embedrapp/parking-ultrasonic/pcb/bom.csv

Quantity | References | Populate | Value | Package | Mount | Manufacturer | MPN | Supplier | Supplier Part Number | Alternatives | Description | Datasheet | Configuration | Zener Paths | Source URL | Currency | Unit Price | Extended Price | Stock | Availability | Sourcing Updated
1 | BZ1 | Yes |  | Radial 12.2 mm, 5 mm pitch |  | TDK | PS1240P02BT |  |  |  | Buzzer, polarized | https://product.tdk.com/en/system/files/dam/doc/product/sw_piezo/sw_piezo/piezo-buzzer/catalog/piezoelectronic_buzzer_ps_en.pdf | Configured | parking_ultrasonic.zen:<root>.BZ1.PS1240P02BT
1 | C1 | Yes | 10uF 16V X5R | 0805 | smt | Samsung Electro-Mechanics | CL21A106KOQNNNE |  |  |  | 10uF 16V X5R |  | Configured | parking_ultrasonic.zen:<root>.C1.C
3 | C2 C4 C5 | Yes | 100nF 50V X7R | 0805 | smt | Samsung Electro-Mechanics | CL21B104KBCNNNC |  |  |  | 100nF 50V X7R |  | Configured | parking_ultrasonic.zen:<root>.C2.C | parking_ultrasonic.zen:<root>.C4.C | parking_ultrasonic.zen:<root>.C5.C
1 | C3 | Yes | 1uF 16V X7R | 0805 | smt | Samsung Electro-Mechanics | CL21B105KOFNNNE |  |  |  | 1uF 16V X7R |  | Configured | parking_ultrasonic.zen:<root>.C3.C
1 | D1 | Yes |  | T-1 3/4 5 mm 3-lead radial |  | SunLED | XLMDKVG59MCA |  |  |  | Dual LED, common anode on pin 2 | https://www.sunledusa.com/products/spec/XLMDKVG59MCA.pdf | Configured | parking_ultrasonic.zen:<root>.D1.XLMDKVG59MCA
1 | D2 | Yes | 5V TVS Diode | DO-214AC |  | Littelfuse | SMAJ5.0A |  |  |  | 5V TVS Diode |  | Configured | parking_ultrasonic.zen:<root>.D2.D
1 | D3 | Yes | LED GREEN | 0805 |  | Lite-On | LTST-C171KGKT |  |  |  | LED GREEN |  | Configured | parking_ultrasonic.zen:<root>.D3.LED
1 | DS1 | Yes |  | 0.96 inch 128x64 OLED breakout module with 1x8 2.54 mm header and STEMMA QT connectors |  | Adafruit Industries | 326 |  |  |  | Adafruit PID 326 0.96 inch 128x64 monochrome SSD1306 OLED breakout with STEMMA QT / Qwiic I2C connectors, 1x8 through-hole header, I2C default configuration, and optional SPI wiring. | https://cdn.embedr.app/components/adafruit-326-ssd1306-oled/datasheet_pdf/UG-2864HSWEG01.pdf | Configured | parking_ultrasonic.zen:<root>.DS1.ADAFRUIT_326_SSD1306_OLED
1 | F1 | Yes |  | 1206 |  | Bourns | MF-NSMF050-2 |  |  |  | Resettable fuse, polymeric positive temperature coefficient | https://www.bourns.com/docs/Product-Datasheets/mf-nsmf.pdf | Configured | parking_ultrasonic.zen:<root>.F1.MF_NSMF050_2
1 | J1 | Yes |  | JST XH 1x10 side entry |  | JST | S10B-XH-A(LF)(SN) |  |  |  | Generic connector, single row, 01x10, script generated (kicad-library-utils/schlib/autogen/connector/) | https://www.jst-mfg.com/product/pdf/eng/eXH.pdf | Configured | parking_ultrasonic.zen:<root>.J1.S10B_XH_A
1 | J2 | Yes |  | HC-SR04 module plugged into Sullins PPPC041LGBN-RC right-angle 1x4 socket |  | SparkFun Electronics | SEN-15569 |  |  |  | SparkFun SEN-15569 5 V HC-SR04 ultrasonic distance sensor module with a 4-pin VCC/TRIG/ECHO/GND interface, 2 cm to 4 m measurement range, and 10 us trigger pulse timing. | https://cdn.embedr.app/components/sparkfun-sen-15569-hc-sr04/datasheet_pdf/HCSR04.pdf | Configured | parking_ultrasonic.zen:<root>.J2.SPARKFUN_SEN_15569_HC_SR04
3 | Q1 Q2 Q3 | Yes |  | SOT-23 |  | Alpha & Omega Semiconductor | AO3400A |  |  |  | 30V Vds, 5.7A Id, N-Channel MOSFET, SOT-23 | http://www.aosmd.com/pdfs/datasheet/AO3400A.pdf | Configured | parking_ultrasonic.zen:<root>.Q1.AO3400A | parking_ultrasonic.zen:<root>.Q2.AO3400A | parking_ultrasonic.zen:<root>.Q3.AO3400A
1 | R1 | Yes | 2.2k | 0805 | smt | YAGEO | RC0805FR-072K2L |  |  |  | 2.2k |  | Configured | parking_ultrasonic.zen:<root>.R1.R
5 | R2 R3 R10 R12 R15 | Yes | 100k | 0805 | smt | YAGEO | RC0805FR-07100KL |  |  |  | 100k |  | Configured | parking_ultrasonic.zen:<root>.R2.R | parking_ultrasonic.zen:<root>.R3.R | parking_ultrasonic.zen:<root>.R10.R | parking_ultrasonic.zen:<root>.R12.R | parking_ultrasonic.zen:<root>.R15.R
1 | R4 | Yes | 33 | 0805 | smt | YAGEO | RC0805FR-0733RL |  |  |  | 33 |  | Configured | parking_ultrasonic.zen:<root>.R4.R
2 | R5 R6 | Yes | 4.7k | 0805 | smt | YAGEO | RC0805FR-074K7L |  |  |  | 4.7k |  | Configured | parking_ultrasonic.zen:<root>.R5.R | parking_ultrasonic.zen:<root>.R6.R
2 | R7 R8 | Yes | 220 | 0805 | smt | YAGEO | RC0805FR-07220RL |  |  |  | 220 |  | Configured | parking_ultrasonic.zen:<root>.R7.R | parking_ultrasonic.zen:<root>.R8.R
3 | R9 R11 R14 | Yes | 100 | 0805 | smt | YAGEO | RC0805FR-07100RL |  |  |  | 100 |  | Configured | parking_ultrasonic.zen:<root>.R9.R | parking_ultrasonic.zen:<root>.R11.R | parking_ultrasonic.zen:<root>.R14.R
1 | R13 | Yes | 1k | 0805 | smt | YAGEO | RC0805FR-071KL |  |  |  | 1k |  | Configured | parking_ultrasonic.zen:<root>.R13.R
1 | U1 | Yes |  | SOT-23-5 | smt | Texas Instruments | SN74AHCT1G125DBVR |  |  |  | Single Buffer Gate Tri-State, Low-Voltage CMOS | https://www.ti.com/lit/ds/symlink/sn74ahct1g125.pdf | Configured | parking_ultrasonic.zen:<root>.U1.BUF
1 | U2 | Yes |  | SOT-23-5 |  | Texas Instruments | SN74LVC1G125DBVR |  |  |  | Single Buffer Gate Tri-State, Low-Voltage CMOS | https://www.ti.com/lit/ds/symlink/sn74lvc1g125.pdf | Configured | parking_ultrasonic.zen:<root>.U2.BUF
