embedrapp/parking-ultrasonic/mechanical/exports/back_plate.stl

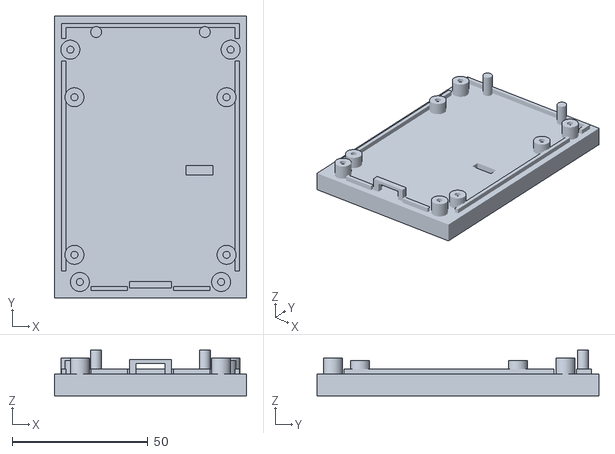
[picture p1: CAD file, 2026-10-16]
mechanical/exports/back_plate.stl
70.8 x 103.8 x 16.9
