embedrapp/parking-ultrasonic/mechanical/imports/parking-board.step

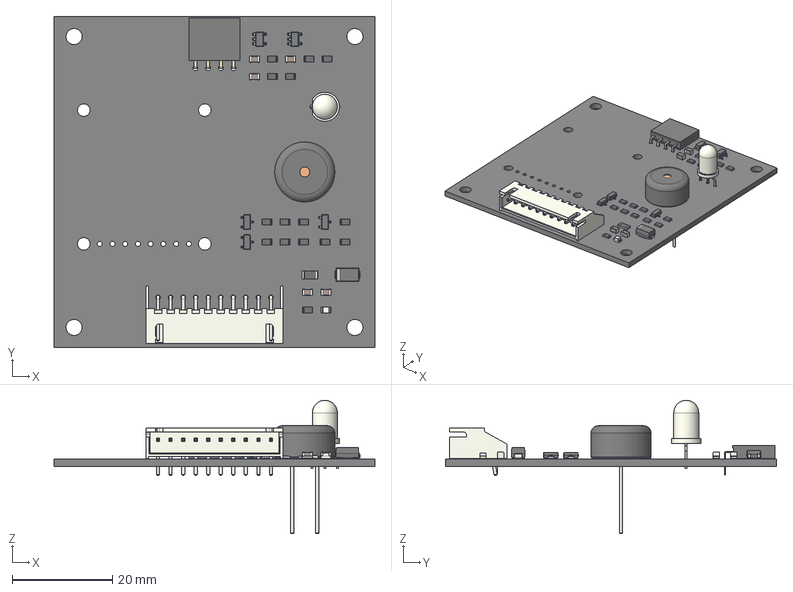
[picture p2: CAD file, 2026-10-16]
mechanical/imports/parking-board.step
64.0 x 66.0 x 26.6 mm
R_0805_2012Metric x 15
Fuse_1206_3216Metric
SOT-23 x 3
JST_XH_S10B-XH-A_1x10_P2.50mm_Horizontal
PinSocket_1x04_P2.54mm_Horizontal
D_SMA
LED_D5.0mm-3
C_0805_2012Metric x 5
Buzzer_TDK_PS1240P02BT_D12.2mm_H6.5mm
LED_0805_2012Metric
SOT-23-5 x 2
layout_PCB
