embedrapp/parking-ultrasonic/mechanical/exports/front_shell.stl

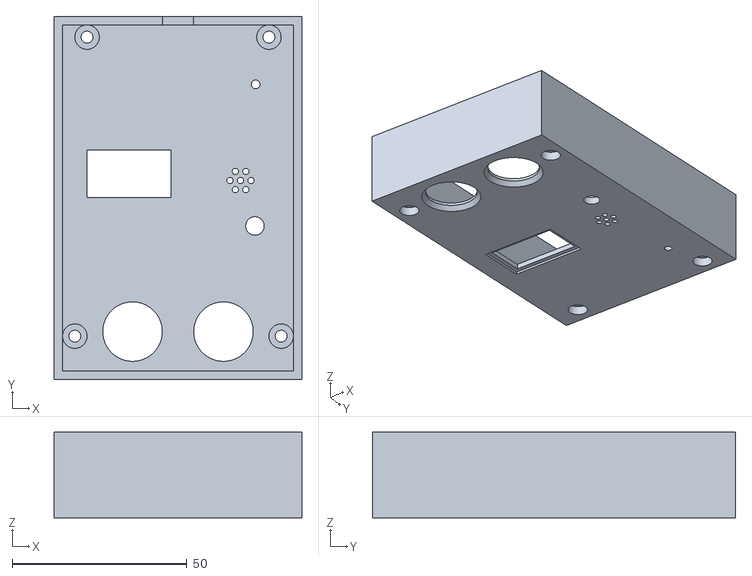
[picture p3: CAD file, 2026-10-16]
mechanical/exports/front_shell.stl
70.8 x 103.8 x 24.5
