embedrapp/parking-ultrasonic/mechanical/exports/parking-case.step

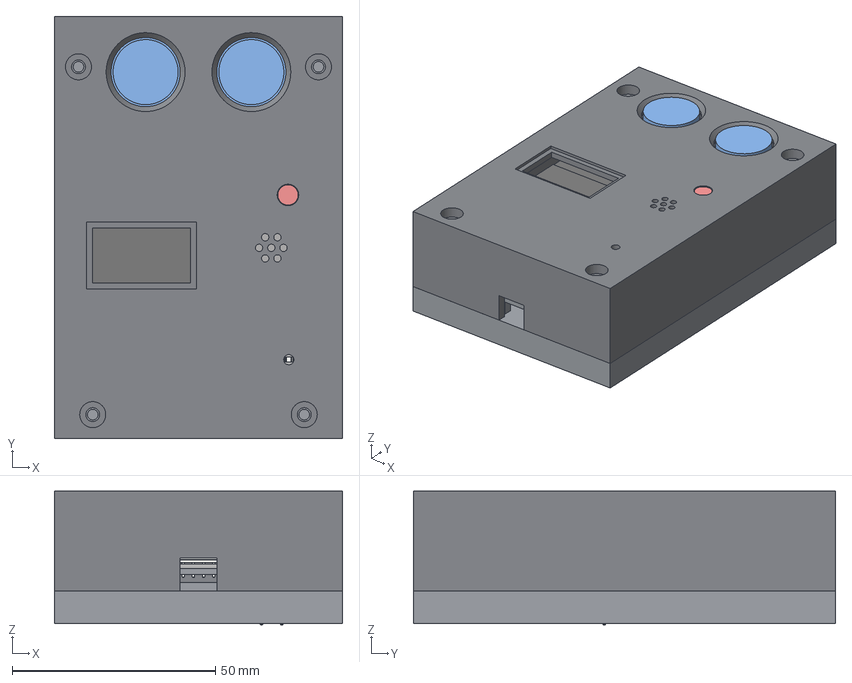
[picture p4: CAD file, 2026-10-16]
mechanical/exports/parking-case.step
70.8 x 103.8 x 32.9 mm
front_shell
back_plate
R_0805_2012Metric x 15
Fuse_1206_3216Metric
SOT-23 x 3
JST_XH_S10B-XH-A_1x10_P2_50mm_Horizontal
PinSocket_1x04_P2_54mm_Horizontal
D_SMA
LED_D5_0mm-3
C_0805_2012Metric x 5
Buzzer_TDK_PS1240P02BT_D12_2mm_H6_5mm
LED_0805_2012Metric
SOT-23-5 x 2
layout_PCB
ref_hcsr04
ref_oled
ref_stop_led
