embedrapp/parking-ultrasonic/pcb/layout/layout.kicad_pcb

## KiCad design pcb/layout/layout.kicad_pcb (2026-10-16)

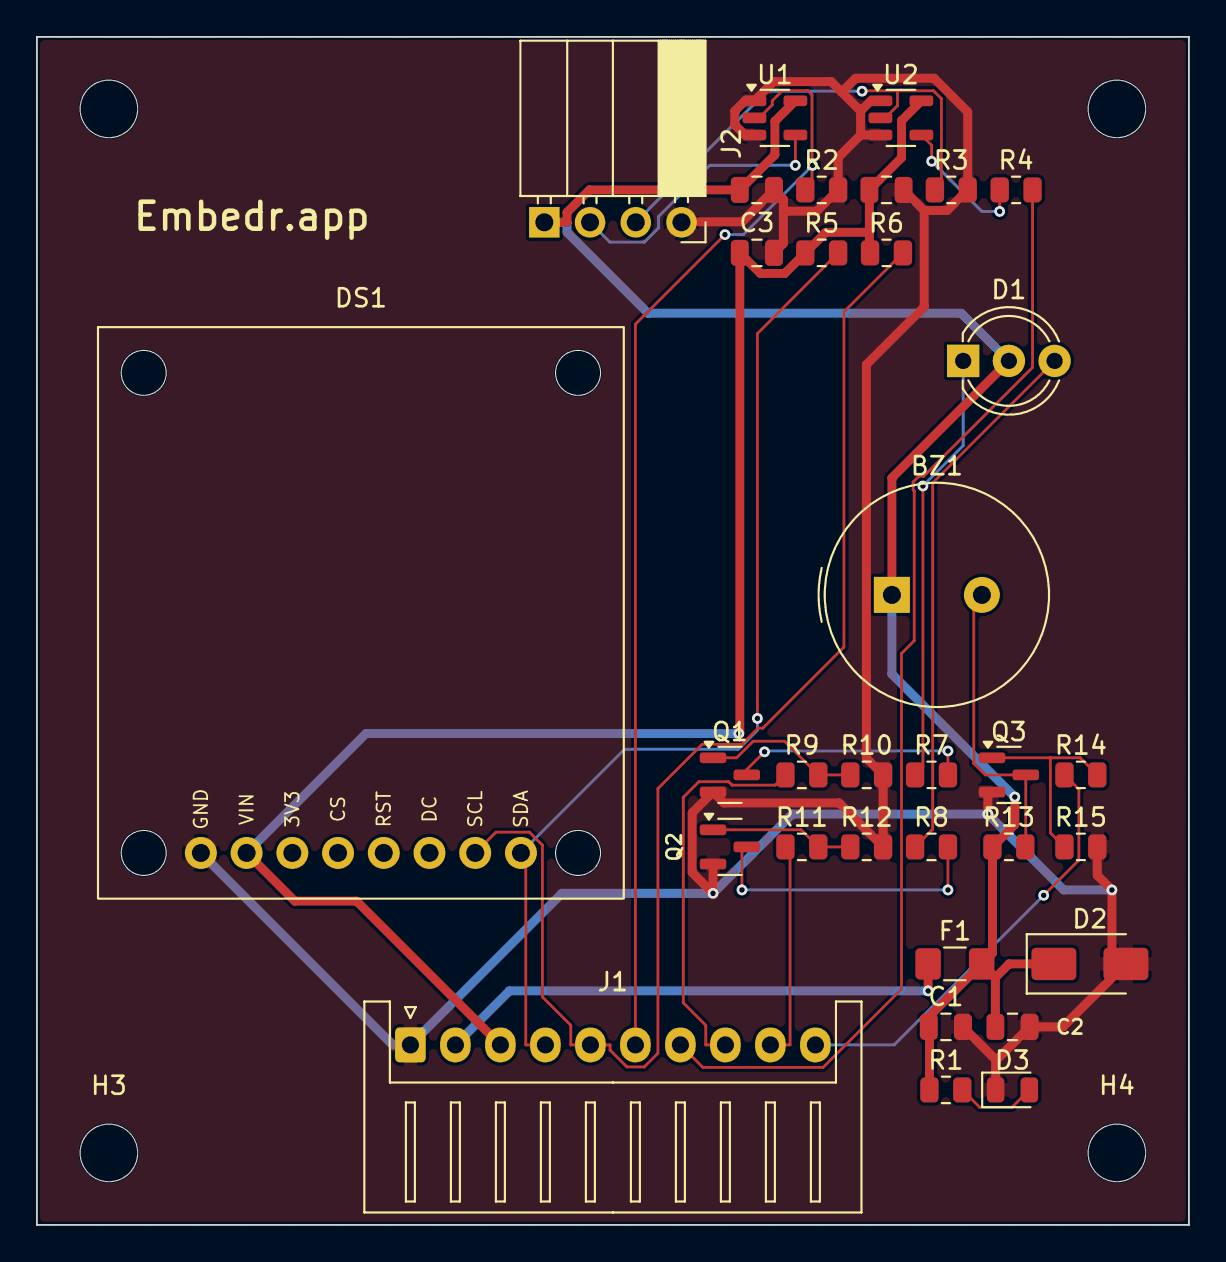
[picture p5: board layout.kicad_pcb from above]

Board: 2 copper layers, 64.0 x 66.0 mm, 37 parts (0 on the bottom side), 23 nets.

Parts:
BZ1: PS1240P02BT; Buzzer_TDK_PS1240P02BT_D12.2mm_H6.5mm
C1: CL21A106KOQNNNE; C_0805_2012Metric
C2, C4, C5: CL21B104KBCNNNC; C_0805_2012Metric
C3: CL21B105KOFNNNE; C_0805_2012Metric
D1: XLMDKVG59MCA; LED_D5.0mm-3
D2: SMAJ5.0A; D_SMA
D3: LTST-C171KGKT; LED_0805_2012Metric
DS1: 326; Adafruit_326_SSD1306_OLED
F1: MF-NSMF050-2; Fuse_1206_3216Metric_Pad1.42x1.75mm_HandSolder
H1, H2, H3, H4: M3 DIN965 Mechanical; MountingHole_3.2mm_M3_DIN965
J1: S10B-XH-A(LF)(SN); JST_XH_S10B-XH-A_1x10_P2.50mm_Horizontal
J2: SEN-15569; HCSR04_Socket_1x04_P2.54mm_Horizontal_PinRev
Q1, Q2, Q3: AO3400A; SOT-23
R1: RC0805FR-072K2L; R_0805_2012Metric
R2, R3, R10, R12, R15: RC0805FR-07100KL; R_0805_2012Metric
R4: RC0805FR-0733RL; R_0805_2012Metric
R5, R6: RC0805FR-074K7L; R_0805_2012Metric
R7, R8: RC0805FR-07220RL; R_0805_2012Metric
R9, R11, R14: RC0805FR-07100RL; R_0805_2012Metric
R13: RC0805FR-071KL; R_0805_2012Metric
U1: SN74AHCT1G125DBVR; SOT-23-5
U2: SN74LVC1G125DBVR; SOT-23-5

Connections:
BUZZ: J1.10, R14.1
BZ_N: BZ1.2, Q3.3, R13.2
ECHO_5V: J2.3, R3.1, U2.2
ECHO_BUF: R4.1, U2.4
ECHO_HOST: J1.7, R4.2
GND: C1.2, C2.2, C3.2, C4.2, C5.2, D2.2, D3.1, DS1.8, J1.1, J2.4, Q1.2, Q2.2, Q3.2, R2.2, R3.2, R10.2, R12.2, R15.2, U1.1, U1.3, U2.1, U2.3
G_BZ: Q3.1, R14.2, R15.1
G_GRN: Q2.1, R11.2, R12.1
G_RED: Q1.1, R9.2, R10.1
K_GREEN: D1.3, R8.1
K_RED: D1.1, R7.1
LED_G: J1.9, R11.1
LED_R: J1.8, R9.1
PWR_LED_A: D3.2, R1.2
Q_GRN_D: Q2.3, R8.2
Q_RED_D: Q1.3, R7.2
SCL: DS1.2, J1.5, R6.2
SDA: DS1.1, J1.4, R5.2
TRIG_5V: J2.2, U1.4
TRIG_HOST: J1.6, R2.1, U1.2
V5: BZ1.1, C1.1, C2.1, C4.1, D1.2, D2.1, F1.2, J2.1, R1.1, R13.1, U1.5
V5_IN: F1.1, J1.2
VIO: C3.1, C5.1, DS1.7, J1.3, R5.1, R6.1, U2.5
